sam-castle/IMU.sic/README.md

# IMU.sic
A Novel Gestural Controller for Live Vocal Processing
